cchalm/pewpew/README.md

# PewPew

PewPew is a laser tag passion project focused on shot reception range and robustness, particularly in multi-attacker scenarios.

PewPew was inspired by the commercial laser tag product from Tiger Electronics (later Nerf), which was a catalyst for many joyful childhood memories.
