cchalm/pewpew/EAGLE/projects/Laser Tag/transceiver_and_pulse_generators.brd

## EAGLE design EAGLE/projects/Laser Tag/transceiver_and_pulse_generators.brd (2025-08-25)

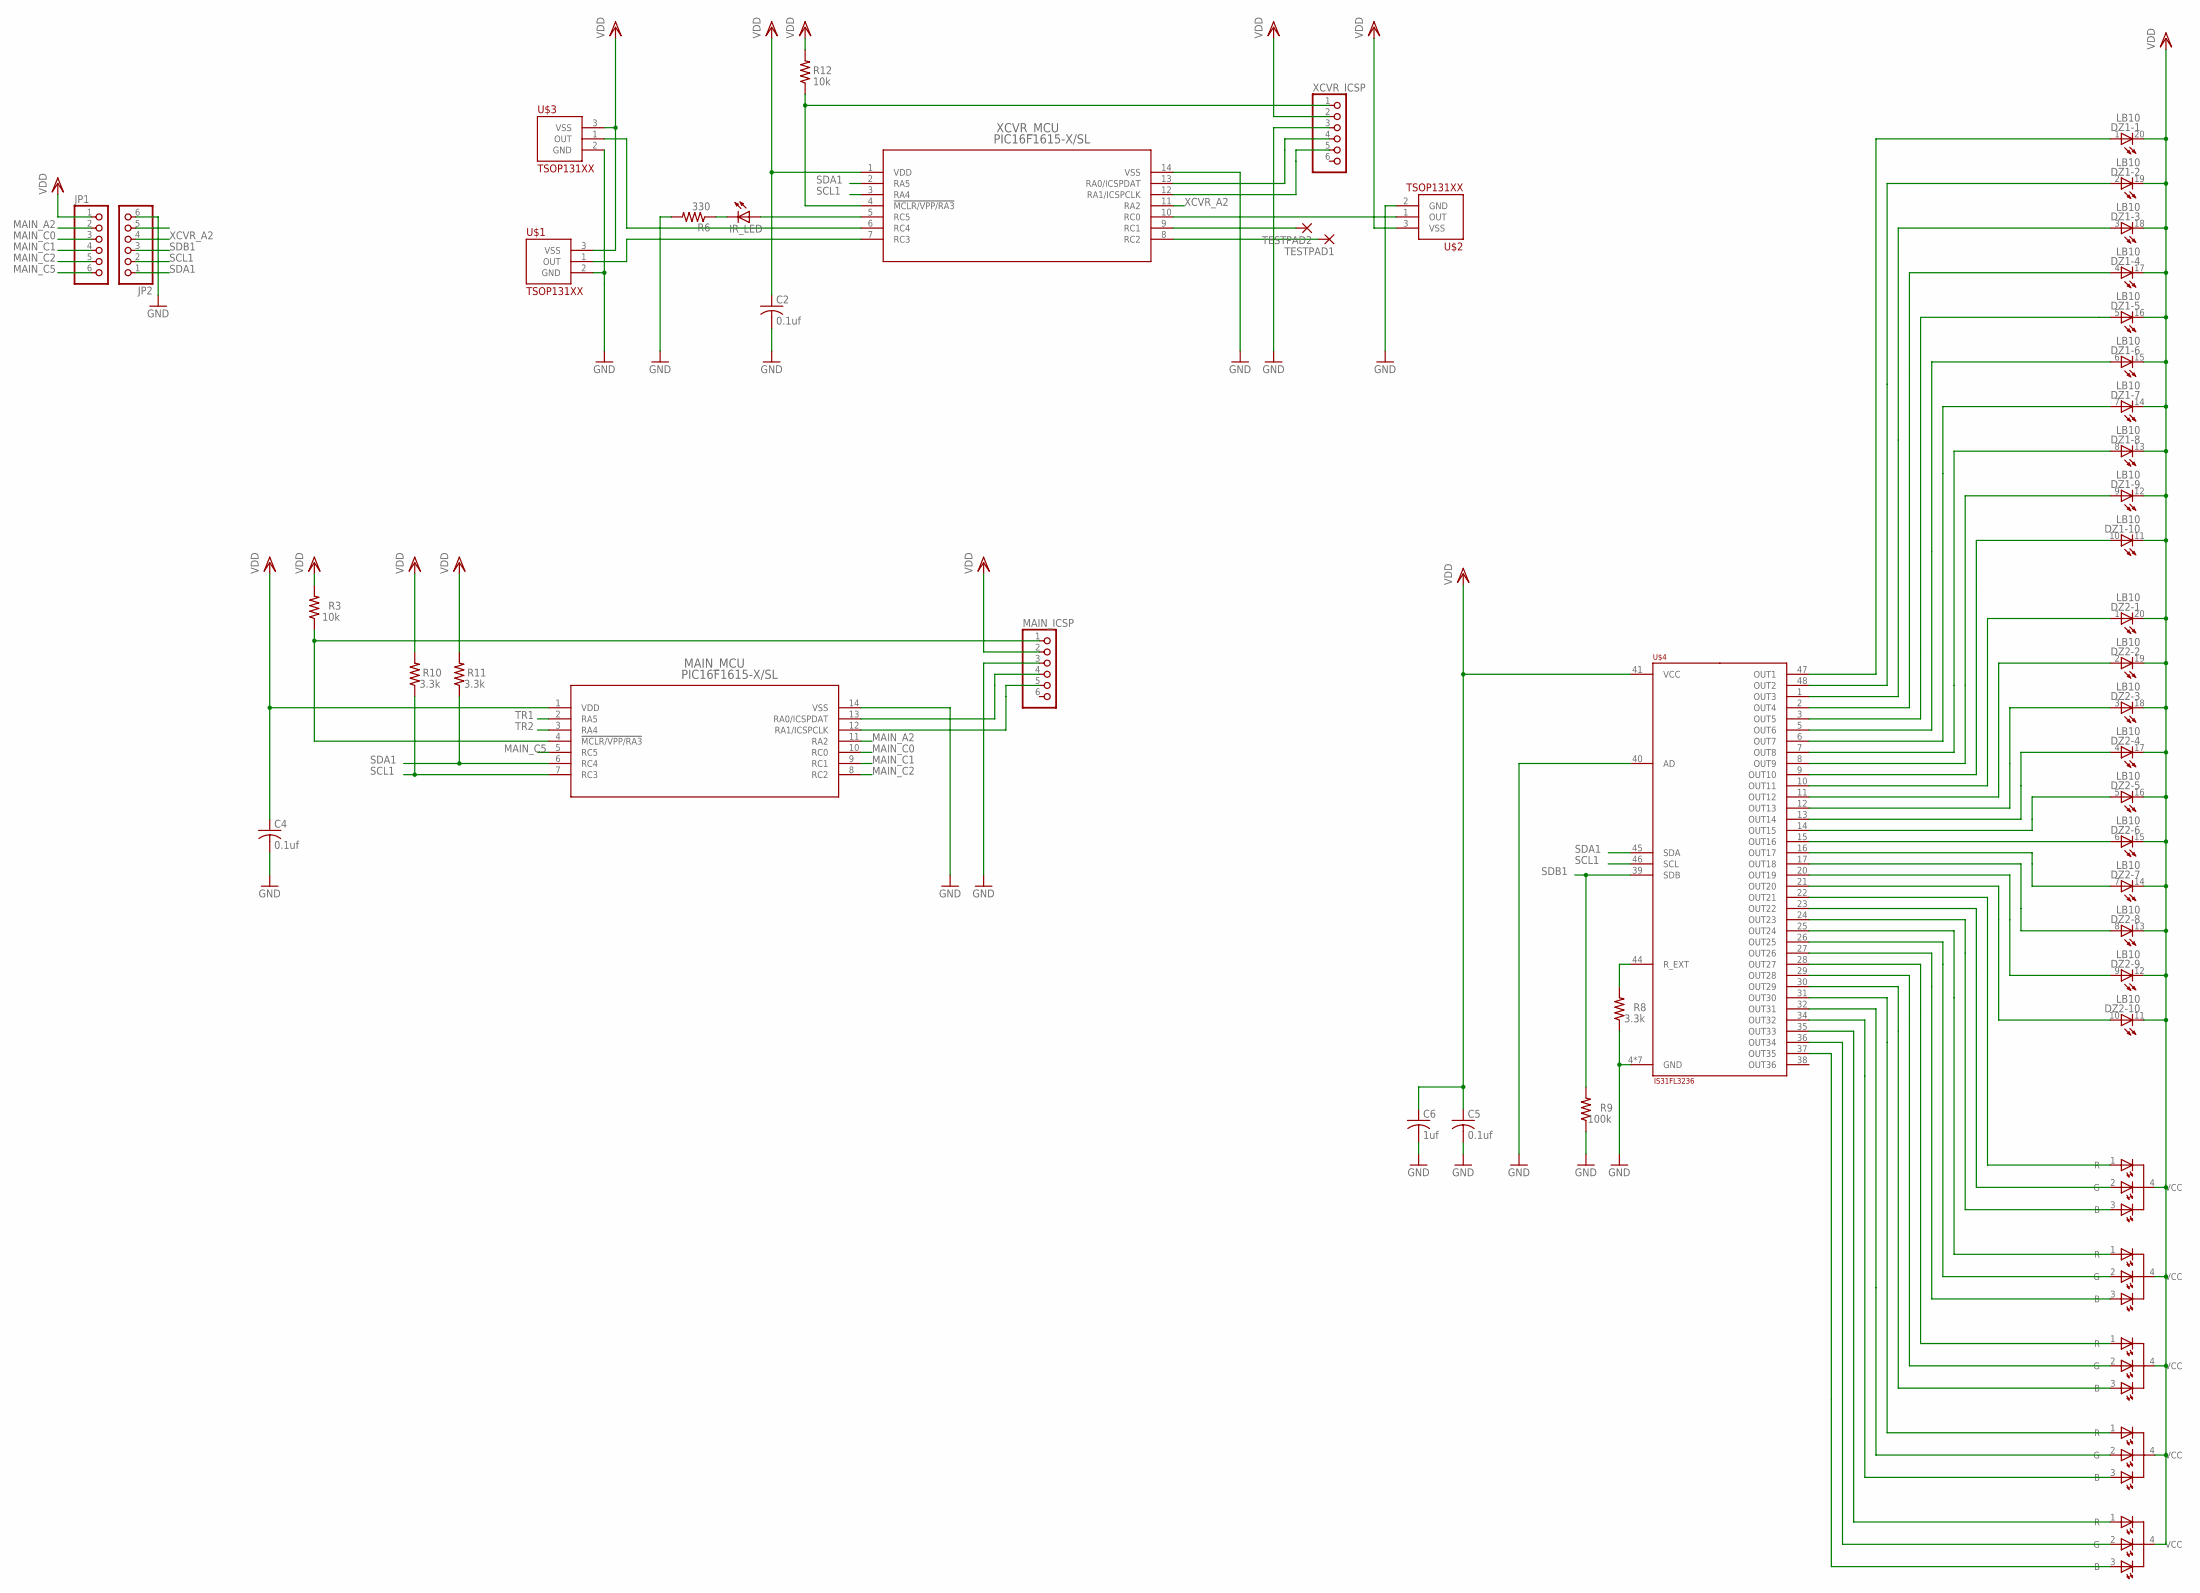
[picture p1: schematic transceiver_and_pulse_generators.sch, sheet 1]

Parts:
C2, C4, C5: 0.1uf; C0603
C6: 1uf; C0603
DZ1, DZ2: LB10
IR_LED: LED5MM
JP1, JP2: PINHD-1X6; 1X06
MAIN_ICSP: PINHD-1X6; 1X06
MAIN_MCU: PIC16F1615-X/SL; SOIC14_SL
R3, R12: 10k; R0603
R6: 330; R0603
R8, R10, R11: 3.3k; R0603
R9: 100k; R0603
TESTPAD1, TESTPAD2: SMD2; SMD1,27-2,54
U$1, U$2, U$3: TSOP131XX; TSOP13XXX
U$4: IS31FL3236
U$5, U$6, U$7, U$8, U$9: LTST-C19HE1WT
XCVR_ICSP: PINHD-1X6; 1X06
XCVR_MCU: PIC16F1615-X/SL; SOIC14_SL

Connections:
GND: C2.2, C4.2, C5.2, C6.2, JP2.6, MAIN_ICSP.3, MAIN_MCU.14 (VSS), R6.2, R8.1, R9.1, U$1.2 (GND), U$2.2 (GND), U$3.2 (GND), U$4.4 (GND), U$4.18 (GND), U$4.19 (GND), U$4.33 (GND), U$4.40 (AD), U$4.42 (GND), U$4.43 (GND), U$4.49 (GND), XCVR_ICSP.3, XCVR_MCU.14 (VSS); also elsewhere on the board
MAIN_A2: JP1.2, MAIN_MCU.11 (RA2)
MAIN_C0: JP1.3, MAIN_MCU.10 (RC0)
MAIN_C1: JP1.4, MAIN_MCU.9 (RC1)
MAIN_C2: JP1.5, MAIN_MCU.8 (RC2)
MAIN_C5: JP1.6, MAIN_MCU.5 (RC5)
unnamed: XCVR_ICSP.5, XCVR_MCU.12 (RA1/ICSPCLK)
unnamed: XCVR_ICSP.4, XCVR_MCU.13 (RA0/ICSPDAT)
unnamed: R12.1, XCVR_ICSP.1, XCVR_MCU.4 (!MCLR/VPP/RA3)
unnamed: IR_LED.A, XCVR_MCU.5 (RC5)
unnamed: IR_LED.K (C), R6.1
unnamed: MAIN_ICSP.1, MAIN_MCU.4 (!MCLR/VPP/RA3), R3.1
unnamed: MAIN_ICSP.5, MAIN_MCU.12 (RA1/ICSPCLK)
unnamed: MAIN_ICSP.4, MAIN_MCU.13 (RA0/ICSPDAT)
unnamed: U$1.1 (OUT), XCVR_MCU.7 (RC3)
unnamed: U$2.1 (OUT), XCVR_MCU.10 (RC0)
unnamed: U$3.1 (OUT), XCVR_MCU.6 (RC4)
unnamed: DZ1.1 (A), U$4.47 (OUT1)
unnamed: DZ1.2 (A), U$4.48 (OUT2)
unnamed: DZ1.3 (A), U$4.1 (OUT3)
unnamed: DZ1.4 (A), U$4.2 (OUT4)
unnamed: DZ1.5 (A), U$4.3 (OUT5)
unnamed: DZ1.6 (A), U$4.5 (OUT6)
unnamed: DZ1.7 (A), U$4.6 (OUT7)
unnamed: DZ1.8 (A), U$4.7 (OUT8)
unnamed: DZ1.9 (A), U$4.8 (OUT9)
unnamed: DZ1.10 (A), U$4.9 (OUT10)
unnamed: DZ2.1 (A), U$4.10 (OUT11)
unnamed: DZ2.2 (A), U$4.11 (OUT12)
unnamed: DZ2.3 (A), U$4.12 (OUT13)
unnamed: DZ2.4 (A), U$4.13 (OUT14)
unnamed: DZ2.5 (A), U$4.14 (OUT15)
unnamed: U$4.37 (OUT35), U$9.3 (B)
unnamed: U$4.36 (OUT34), U$9.2 (G)
unnamed: U$4.35 (OUT33), U$9.1 (R)
unnamed: U$4.34 (OUT32), U$8.3 (B)
unnamed: U$4.32 (OUT31), U$8.2 (G)
unnamed: U$4.31 (OUT30), U$8.1 (R)
unnamed: U$4.30 (OUT29), U$7.3 (B)
unnamed: U$4.29 (OUT28), U$7.2 (G)
unnamed: U$4.28 (OUT27), U$7.1 (R)
unnamed: U$4.27 (OUT26), U$6.3 (B)
unnamed: U$4.26 (OUT25), U$6.2 (G)
unnamed: U$4.25 (OUT24), U$6.1 (R)
unnamed: U$4.24 (OUT23), U$5.3 (B)
unnamed: U$4.23 (OUT22), U$5.2 (G)
unnamed: U$4.22 (OUT21), U$5.1 (R)
unnamed: DZ2.10 (A), U$4.21 (OUT20)
unnamed: DZ2.9 (A), U$4.20 (OUT19)
unnamed: DZ2.8 (A), U$4.17 (OUT18)
unnamed: DZ2.7 (A), U$4.16 (OUT17)
unnamed: DZ2.6 (A), U$4.15 (OUT16)
unnamed: R8.2, U$4.44 (R_EXT)
RESERVED1: TESTPAD1.1, XCVR_MCU.8 (RC2)
RESERVED2: TESTPAD2.1, XCVR_MCU.9 (RC1)
SCL1: JP2.2, MAIN_MCU.7 (RC3), R10.1, U$4.46 (SCL), XCVR_MCU.3 (RA4)
SDA1: JP2.1, MAIN_MCU.6 (RC4), R11.1, U$4.45 (SDA), XCVR_MCU.2 (RA5)
SDB1: JP2.3, R9.2, U$4.39 (SDB)
TR1: MAIN_MCU.2 (RA5); also elsewhere on the board
TR2: MAIN_MCU.3 (RA4); also elsewhere on the board
VDD: C2.1, C4.1, C5.1, C6.1, DZ1.11 (C), DZ1.12 (C), DZ1.13 (C), DZ1.14 (C), DZ1.15 (C), DZ1.16 (C), DZ1.17 (C), DZ1.18 (C), DZ1.19 (C), DZ1.20 (C), DZ2.11 (C), DZ2.12 (C), DZ2.13 (C), DZ2.14 (C), DZ2.15 (C), DZ2.16 (C), DZ2.17 (C), DZ2.18 (C), DZ2.19 (C), DZ2.20 (C), JP1.1, MAIN_ICSP.2, MAIN_MCU.1 (VDD), R3.2, R10.2, R11.2, R12.2, U$1.3 (VSS), U$2.3 (VSS), U$3.3 (VSS), U$4.41 (VCC), U$5.4 (VCC), U$6.4 (VCC), U$7.4 (VCC), U$8.4 (VCC), U$9.4 (VCC), XCVR_ICSP.2, XCVR_MCU.1 (VDD); also elsewhere on the board
XCVR_A2: JP2.4, XCVR_MCU.11 (RA2)

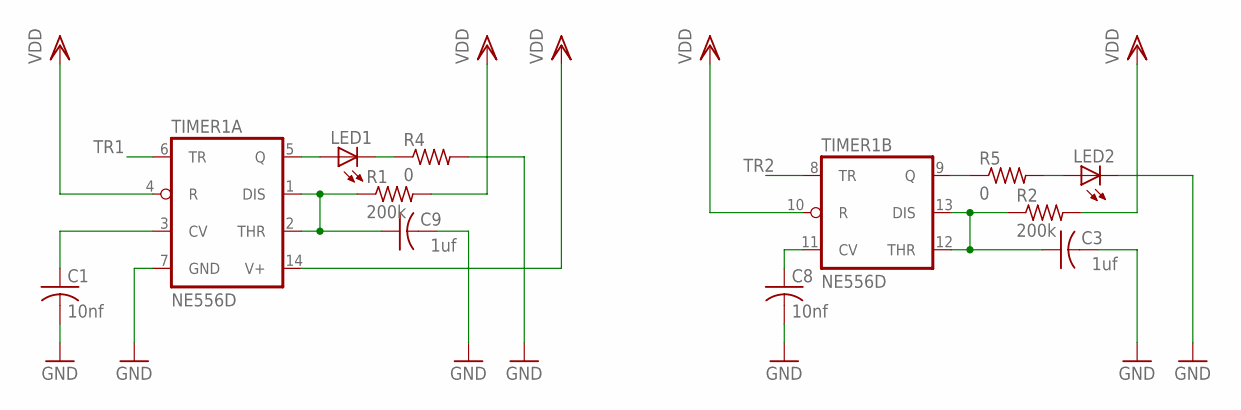
[picture p2: schematic transceiver_and_pulse_generators.sch, sheet 2]

Parts:
C1, C8: 10nf; C0603
C3, C9: 1uf; C0603
LED1, LED2: LED5MM
R1, R2: 200k; R0603
R4, R5: 0; R0603
TIMER1: NE556D; SO14

Connections:
GND: C1.2, C3.2, C8.2, C9.2, LED2.K (C), R4.2, TIMER1.7 (GND); also elsewhere on the board
unnamed: C3.1, R2.1, TIMER1.12 (THR), TIMER1.13 (DIS)
unnamed: C9.1, R1.1, TIMER1.1 (DIS), TIMER1.2 (THR)
unnamed: C8.1, TIMER1.11 (CV)
unnamed: C1.1, TIMER1.3 (CV)
unnamed: LED1.A, TIMER1.5 (Q)
unnamed: LED1.K (C), R4.1
unnamed: R5.1, TIMER1.9 (Q)
unnamed: LED2.A, R5.2
TR1: TIMER1.6 (TR); also elsewhere on the board
TR2: TIMER1.8 (TR); also elsewhere on the board
VDD: R1.2, R2.2, TIMER1.4 (R), TIMER1.10 (R), TIMER1.14 (V+); also elsewhere on the board

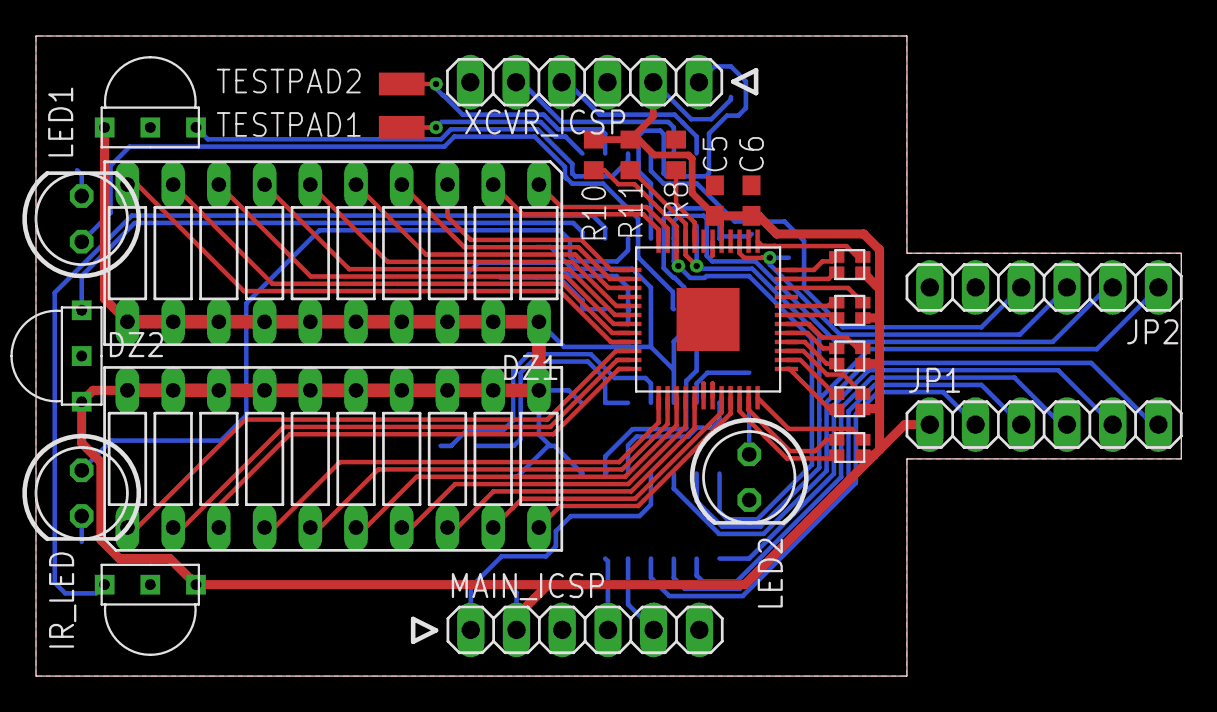
[picture p3: board transceiver_and_pulse_generators.brd from above]

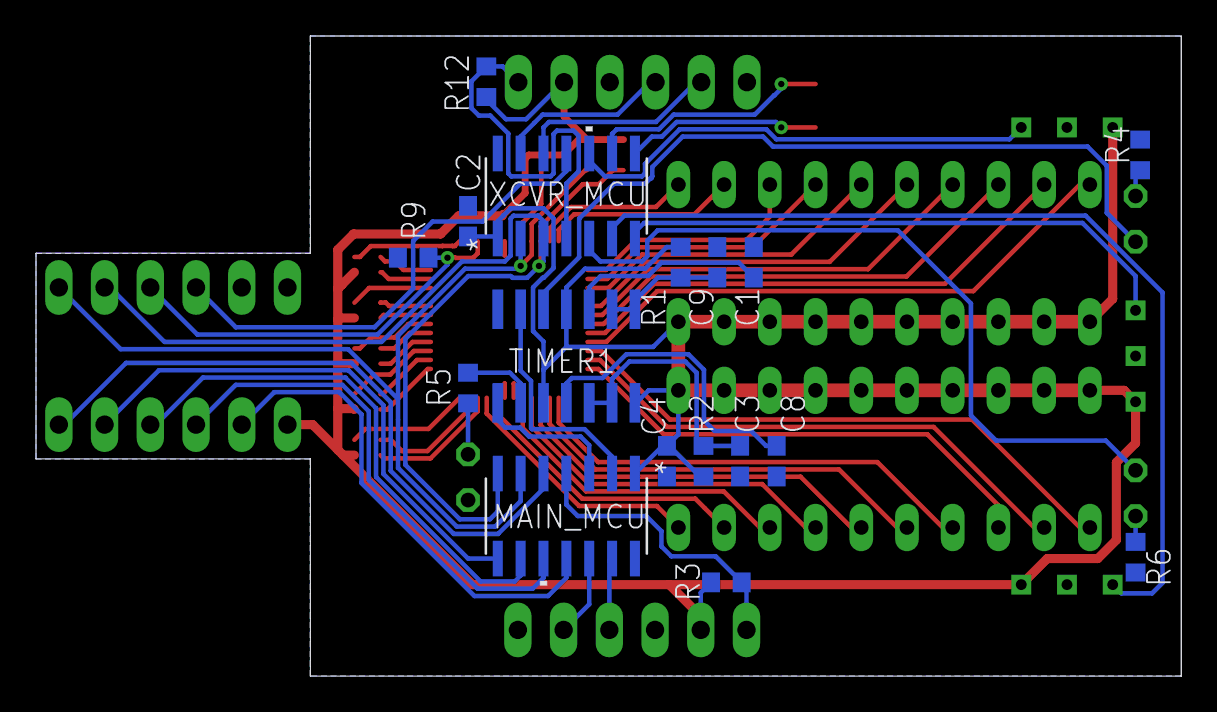
[picture p4: board transceiver_and_pulse_generators.brd from below]

Board: 2 copper layers, 63.6 x 35.6 mm, 42 parts (17 on the bottom side), 70 nets.
