cchalm/pewpew/LaserTag.X/inputs.c

#include "inputs.h"

void sampleInputs()
{
    // TODO
}

bool inputEvent_triggerPressed(void)
{
    // TODO
    return false;
}

bool inputEvent_triggerReleased(void)
{
    // TODO
    return false;
}

bool inputEvent_magazineEjected(void)
{
    // TODO
    return false;
}

bool inputEvent_magazineInserted(void)
{
    // TODO
    return false;
}

bool inputState_triggerPressed(void)
{
    // TODO
    return false;
}

bool inputState_magazineIn(void)
{
    // TODO
    return false;
}
