cchalm/pewpew/LaserTagTransceiver.X/IRReceiverStats.h

#ifndef IRRECEIVERSTATS_H
#define IRRECEIVERSTATS_H

/*
 * Our sensor is a TSOP13556 @ 56kHz. The datasheet specifies that each pulse
 * must be at least 6 cycles, and that the gap between pulses must be at least
 * 10 cycles.
 *
 * Pulses greater than 24 cycles @ 56khz must be separated by gaps of at least
 * 25ms, so our pulse lengths must be less than 24 cycles.
 *
 * The receiver can receive a maximum of 1800 bursts per second, so divide that
 * by the number of bits in a shot and that's the hardware-enforced maximum shot
 * reception rate. For example if there are 10 bits in a shot then the maximum
 * fire rate is 180 shots per second.
 */

#define RECEIVER_MODULATION_FREQ 56000  // 56kHz
#define RECEIVER_PULSE_MIN_CYCLES 6
#define RECEIVER_GAP_MIN_CYCLES 10

// If the receiver receives an optical signal pulse consisting of x modulation
// cycles, it will output an electrical signal up to
// RECEIVER_PULSE_LENGTH_BIAS_UPPER_BOUND_MOD_CYCLES cycles longer than the
// optical signal, and down to RECEIVER_PULSE_LENGTH_BIAS_LOWER_BOUND_MOD_CYCLES
// cycles shorter than the optical signal.
// To increase resolution, these values are both 10x the real value.
// We have decided to widen the range of valid pulse lengths to beyond spec.
// This allows us to handle lower irradiances, which is important for range, but
// also increases the length of all transmissions. In both constants below, the
// first value is according to spec, and the second value is our adjustment.
// These should be adjusted empirically based on testing in various
// environments. Longer transmission may affect range when aiming a tagger with
// shaky hands, for example.
#define RECEIVER_PULSE_LENGTH_BIAS_UPPER_BOUND_MOD_CYCLES_x10 (35 + 40)
#define RECEIVER_PULSE_LENGTH_BIAS_LOWER_BOUND_MOD_CYCLES_x10 (30 + 0)

#define EVALUATE_CONSTANTS
#ifdef EVALUATE_CONSTANTS
#include <stdint.h>
const volatile uint32_t RECEIVER_MODULATION_FREQ_eval = RECEIVER_MODULATION_FREQ;
const volatile uint8_t RECEIVER_PULSE_MIN_CYCLES_eval = RECEIVER_PULSE_MIN_CYCLES;
const volatile uint8_t RECEIVER_GAP_MIN_CYCLES_eval = RECEIVER_GAP_MIN_CYCLES;
const volatile uint8_t RECEIVER_PULSE_LENGTH_BIAS_UPPER_BOUND_MOD_CYCLES_x10_eval
    = RECEIVER_PULSE_LENGTH_BIAS_UPPER_BOUND_MOD_CYCLES_x10;
const volatile uint8_t RECEIVER_PULSE_LENGTH_BIAS_LOWER_BOUND_MOD_CYCLES_x10_eval
    = RECEIVER_PULSE_LENGTH_BIAS_LOWER_BOUND_MOD_CYCLES_x10;
#endif

#endif /* IRRECEIVERSTATS_H */
