cchalm/pewpew/(commit log)

2015-02-07 Revamp shot reception. Close #2
    When receiving a shot, both the "on" and "off" pulses are now measured.
    Reading an unexpected pulse length resets shot reception logic, making
    shot reception more robust. These changes also simplify the shot
    reception code significantly. The new logic is robust enough that I
    believe #1 is no longer necessary.
    [main.c, system.c, system.h]
2015-05-22 Add startup blink to identify resets. Misc changes
    [main.c]
2015-05-23 Add debug mode, fix overflow count bug when receiving shots, edit and document post gap length
    [main.c, system.h]
2015-05-29 Switch around CCP modules, use CCP1 for shooting so we can hook it up to PSMC1 in the future
2015-06-03 Fix a two-byte read race on TMR1, adjust shot timing
    [main.c]
2015-11-03 Close #2. Prescale Timer1 8x
2015-11-05 Close #7. Fix extra cycles in pulses. Reduce cycles in "one" pulses from 20 to 16. Catch shot overlap. Update shooting documentation
    [main.c, system.c, system.h]
2018-08-10 Fix compatibility with C99. Typos
    [main.c]
2018-08-10 Fix bug introduced when renaming things
    [main.c]
2018-08-10 Update pulse timing explanation to reflect the current implementation
2018-08-12 Switch to stdbool
2018-08-12 Separate LED display code
2018-08-12 Invert some debug ifdefs, add comment
    [IRReceiver.c]
2018-08-14 Handle timer overflows in IRReceiver
2018-08-18 <BREAKING> Initial switch to 16f18877, main configuration options
2018-08-19 <FIXES BUILD> First draft of migrating signal reception to 16F18877
    [IRReceiver.c, main.c, transmissionConstants.h]
2018-08-19 <RTC WORKING> Fix RTC prescaler
    [realTimeClock.c]
2018-08-19 <FIXES TRANSMISSION> Use correct clock sources for transmission reception modules + other fixes
    [IRTransmitter.c, main.c, realTimeClock.c]
2018-08-20 <FIXES RECEPTION> Various SMT configuration and operation fixes
    [IRReceiver.c, IRTransmitter.c, main.c, system.c]
2018-08-22 Allow various clock frequencies for transmission. Switch to 40kHz. Close #16
2018-08-22 Switch to TSOP13556. Close #10
2018-08-22 Derive timing tolerances from receiver datasheet. Close #19
    [IRReceiver.c, IRReceiverStats.h, transmissionConstants.h]
2018-08-23 Use Timer0 to time transmission pulses. Invalidate #18. Invalidate #20
2018-08-25 Pull transmission output logic out of the interrupt handler. Close #21
2018-08-25 Pull transmission reception logic out of the interrupt handler. Close #22
2018-08-25 Remove rand() calls, catch unhandled interrupt data
2018-08-26 Replace DSM with CLC. Close #28
    [IRTransmitter.c]
2018-09-13 Replace parity bits with CRC
    [IRReceiver.c, IRReceiver.h, IRTransmitter.c, IRTransmitter.h, main.c, system.c, transmissionConstants.h]
2018-09-14 Add missing crc files
    [crc.c, crc.h, crcConstants.h]
2018-09-15 Increase physical receiver pulse length tolerance
    [IRReceiverStats.h]
2018-12-17 <BREAKING> Initial transition to PCB, including LED driver
2018-12-19 Implement I2C message queue
2019-01-01 Standardize function names, add i2c slave stubs
2019-01-13 Implement I2C master read functionality
2019-01-13 Implement first draft of I2C slave logic in transceiver
2019-01-17 Fix build break, fix pop middle implementation
    [i2cMaster.c, i2cMaster.h, main.c]
2019-01-19 Manually optimize power-of-two division and modulo
2019-01-21 Simplify circularBuffer and make it more thread safe
2019-01-22 Fix OBOE in IR transmitter
    [IRTransmitter.c]
2019-01-24 Fix address pushed onto read buffer, implement partial write
    [i2cMaster.c, i2cMaster.h]
2019-01-25 Add zero length read error
    [error.h, i2cMaster.c, i2cMaster.h]
2019-02-06 Fix reload input pin
    [pins.h]
2019-02-26 Switch RTC counters to 32-bit
2019-03-03 Fix buffer overrun by redesigning irTransceiver_receive
    [error.h, irTransceiver.c, irTransceiver.h, main.c, realTimeClock.c]
2019-03-07 Remove state machine in I2C slave firmware to fix missed state transitions bug
    [error.h, i2cSlave.c, main.c]
2025-08-25 Add schematics
    [transceiver_and_pulse_generators.brd, transceiver_and_pulse_generators.sch]
